cdrfiuba/tco/Informe/codigo_fuente.pdf

Proyecto (66.09) [Junio 2013] | TCO

## 1. Codigo fuente

## main.c

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

Proyecto (66.09) [Junio 2013] | TCO

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

## main.h

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

## motores.c

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

Proyecto (66.09) [Junio 2013] | TCO

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

Proyecto (66.09) [Junio 2013] | TCO
176 | i f ( d i s t a n c i a < 0 x00000650 ) {
177
178 | variar_PWM ( 2 0 0 , 2 0 0 ) ;
179
180 | PORTD | = MOTOR_DER_DIRECTION; | / / Pongo en a l t o e l pi n DIRECTION
| d e l m ot o r 1
181 | PORTB &= ~MOTOR_DER_BRAKE; | / / Pongo en b aj o e l pi n BRAKE d e l
| m ot o r 1
182
183 | PORTD | = MOTOR_IZQ_DIRECTION ; | / / Pongo en a l t o e l pi n DIRECTION
| d e l m ot o r 2
184 | PORTB &= ~MOTOR_IZQ_BRAKE; | / / Pongo en b aj o e l pi n BRAKE d e l
| m ot o r 2
185
186 | w hil e ( f l a g _ f i n _ r o t a c i o n == FALSE ) {
187
188 | i f ( c u e n t a _ e n c o d e r _ d e r e c h a >= 1 5 ) {
189
190 | i f ( c u e n t a _ e n c o d e r _ i z q u i e r d a >= 1 5 ) {
191
192 | f l a g _ f i n _ r o t a c i o n = TRUE;
193
194 | }
195 | }
196 | }
197 | }
198
199 | i f ( d i s t a n c i a > 0 x00000750 ) {
200
201 | variar_PWM ( 2 0 0 , 2 0 0 ) ;
202
203 | PORTD &= ~MOTOR_DER_DIRECTION; | / / Pongo en b aj o e l pi n DIRECTION
| d e l m ot o r 1
204 | PORTB &= ~MOTOR_DER_BRAKE; | / / Pongo en b aj o e l pi n BRAKE d e l
| m ot o r 1
205
206 | PORTD &= ~MOTOR_IZQ_DIRECTION ; | / / Pongo en b aj o e l pi n DIRECTION
| d e l m ot o r 2
207 | PORTB &= ~MOTOR_IZQ_BRAKE; | / / Pongo en b aj o e l pi n BRAKE d e l
| m ot o r 2
208
209 | w hil e ( f l a g _ f i n _ r o t a c i o n == FALSE ) {
210
211 | i f ( c u e n t a _ e n c o d e r _ d e r e c h a >= 1 5 ) {
212
213 | i f ( c u e n t a _ e n c o d e r _ i z q u i e r d a >= 1 5 ) {
214
215 | f l a g _ f i n _ r o t a c i o n = TRUE;
216
217 | }
218 | }
219 | }
220 | }
221 | }

Proyecto (66.09) [Junio 2013] | TCO

## motores.h

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

## encoders.c

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

Proyecto (66.09) [Junio 2013] | TCO
12 | PORTD | &= ~(1 < <PD2 ) ; | / / D e s a c t i v o e l p u l l up
13
14 | GICR | | = (1 < < INT0 ) ; | / / A c t i v o INT0
15 | GICR | | = (1 < < INT1 ) ; | / / A c t i v o INT1
16 | / / GICR &= ~(1<< INT2 ) ; | / / D e s a c t i v o INT2
17
18 | MCUCR | | = ( (1 < < ISC01 ) | (1 < < ISC00 ) ) ; | / / C o nfi g u r o l a INT0 p o r
f l a n c o a s c e n d e n t e
19 | MCUCR | | = ( (1 < < ISC11 ) | (1 < < ISC10 ) ) ; | / / C o nfi g u r o l a INT1 p o r
f l a n c o a s c e n d e n t e 20
21 }

## encoders.h

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

## pwm.c

1
2 # i n cl u d e "pwm. h "
3
4 v oi d i ni ci ali z a r _ PWM ( v oi d ) {
5
6 TCCR1A = ( ( 1 << COM1A1) | ( 1 << COM1A0) | ( 1 << COM1B1) | ( 1 << COM1B0) | ( 0 <<
WGM11) | ( 1 << WGM10) ) ;
7 | / / COM1A1=1 , COM1A0=1 , COM1B1=1 , COM1B0=1 , WGM11=0 , WGM10=1
8 | / / C o n f i g u r a c i o n d e l PWM como f a s t PWM de 8 b i t s
9
10 | TCCR1B = ( ( 0 << WGM13) | ( 1 << WGM12) ) ;
11 | / / Time r Apagado WGM13=0 , WGM12=1 , CS12=0 , CS11=0 , CS10=0
12
13 | / / C o n f i g u r a c i o n de d i r e c c i o n de p u e r t o s I /O
14 | / / DDRA=0x00 ; / / P u e rt o A como e nt r a d a
15 | / / DDRC=0xFF ; / / P u e rt o C como s a l i d a
16 | / / DDRD=0xFF ; / / Pi n 3 y 4 d e l p u e r t o B como s a l i d a
17 | DDRD | = (1 < <4 ) | ( 1 < < 5 ) ;
18 | / / PORTA=0xFF ; / / H a b i l i t a c i o n de p u l l −u p s d e l p u e r t o A

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

## pwm.h

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

## sensoresPared.c

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

Proyecto (66.09) [Junio 2013] | TCO

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

Proyecto (66.09) [Junio 2013] | TCO
68 | r e t u r n c u e n t a s ;
69 | }

## sensoresPared.h

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

## sensoresPiso.c

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

Proyecto (66.09) [Junio 2013] | TCO

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

## sensoresPiso.h

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
