cdrfiuba/tco/Anteproyecto/diagrama_bloques_hard.png

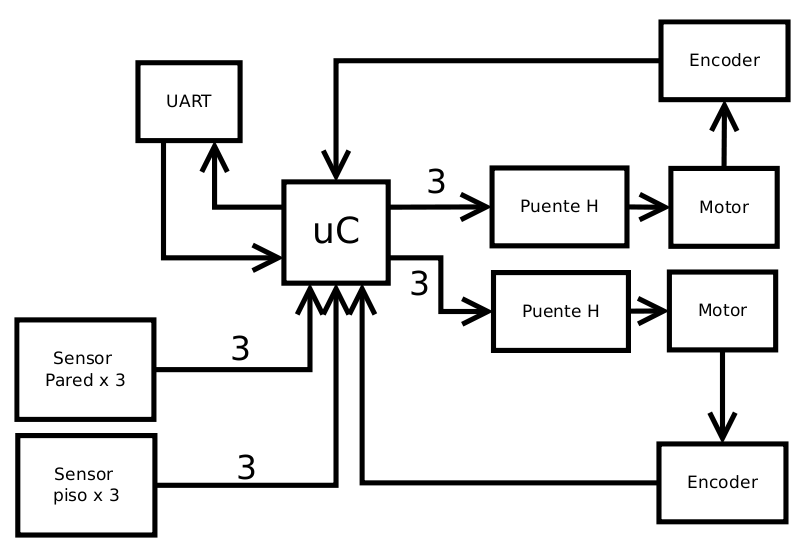
Anteproyecto/diagrama_bloques_hard.png
