cdrfiuba/tco/Anteproyecto/diagrama_flujo.png

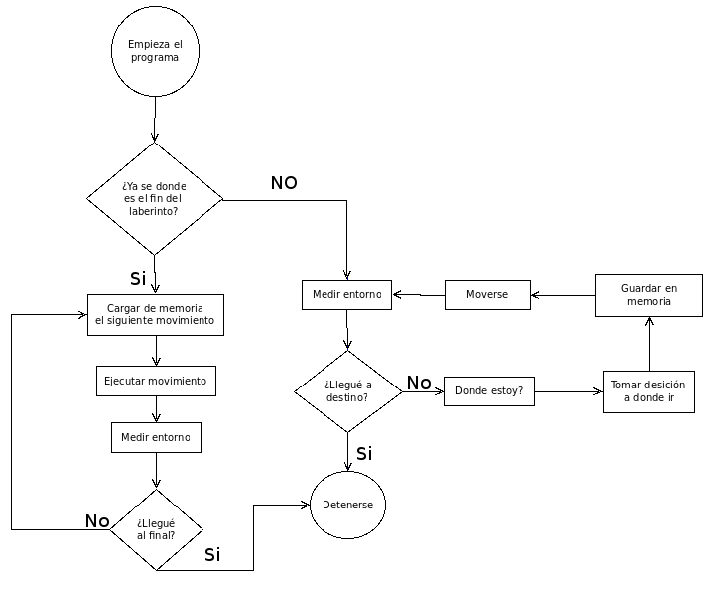
Anteproyecto/diagrama_flujo.png
