cdrfiuba/tco/2013C1TCO/TCO/Esquemáticos/alimentacion.pdf

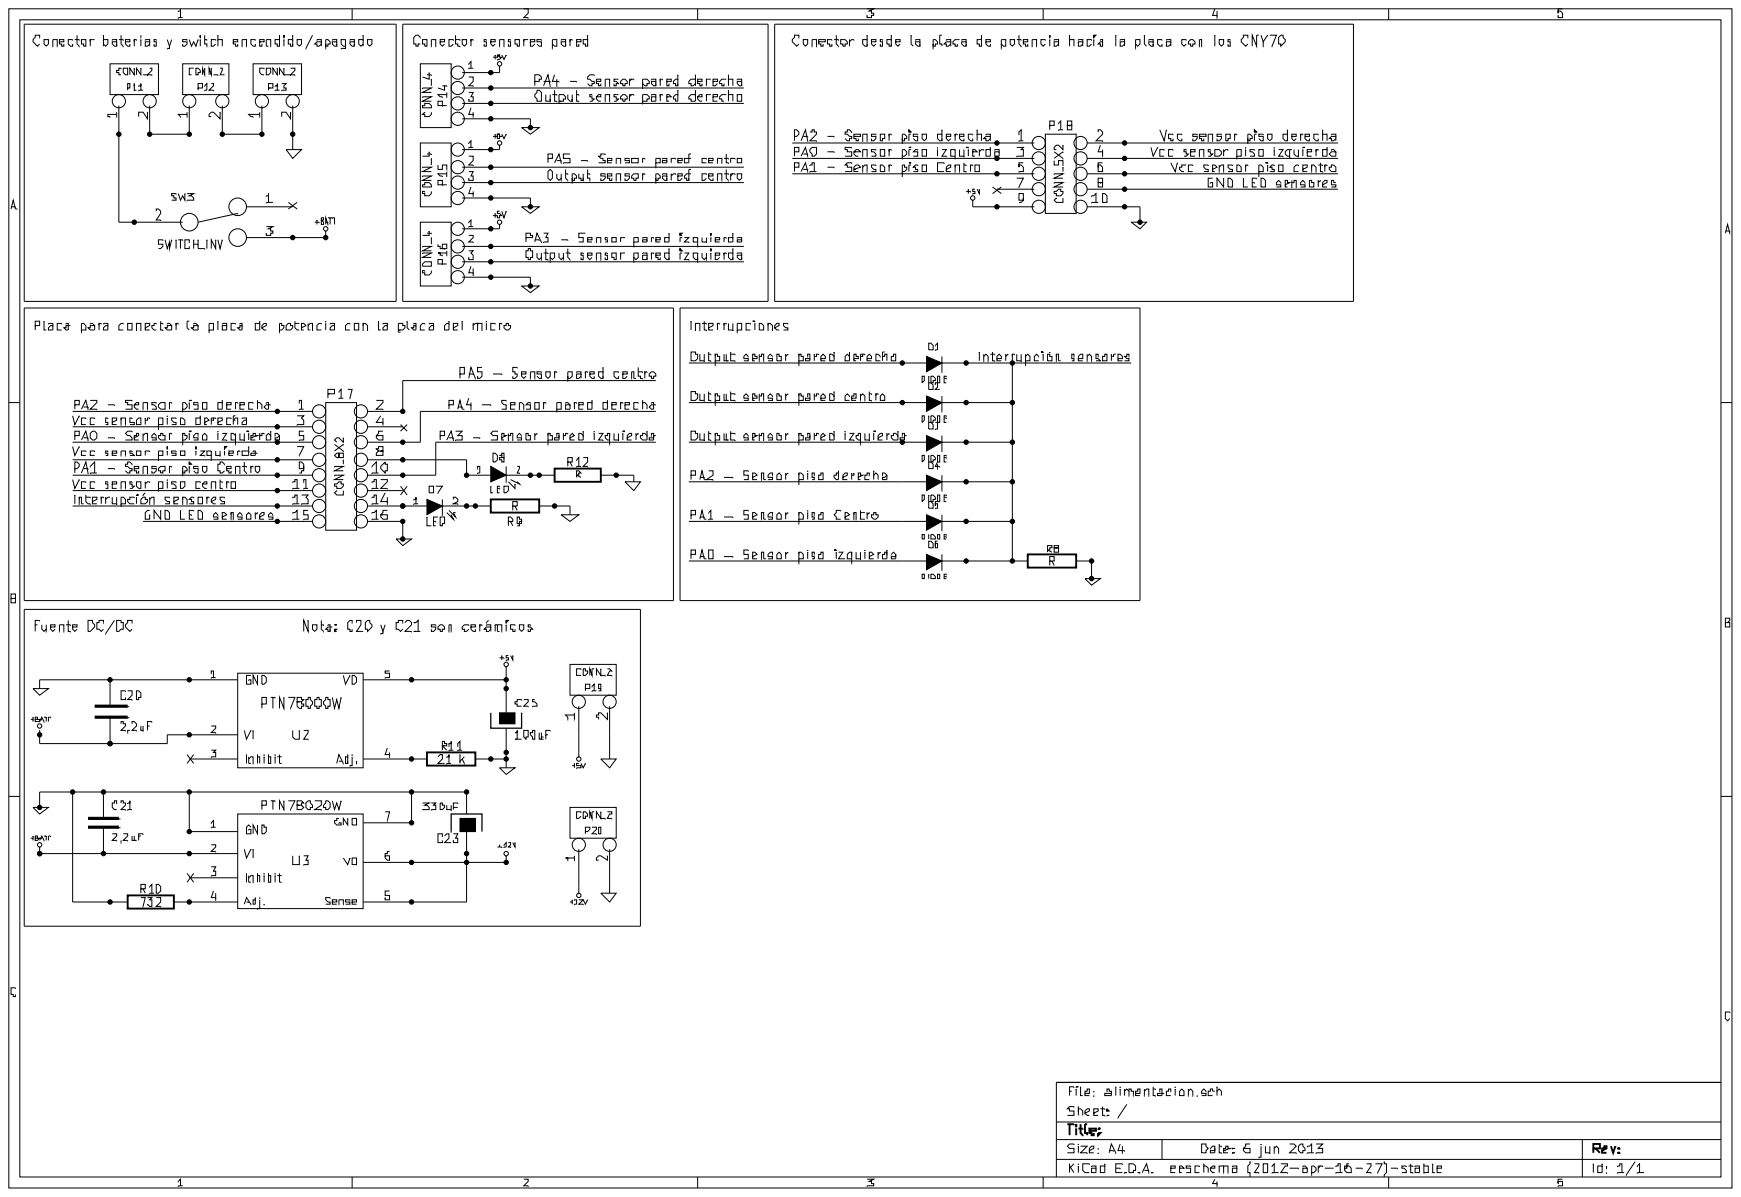
[picture p19: page 1]
