cdrfiuba/tco/2013C1TCO/TCO/Esquemáticos/micro.pdf

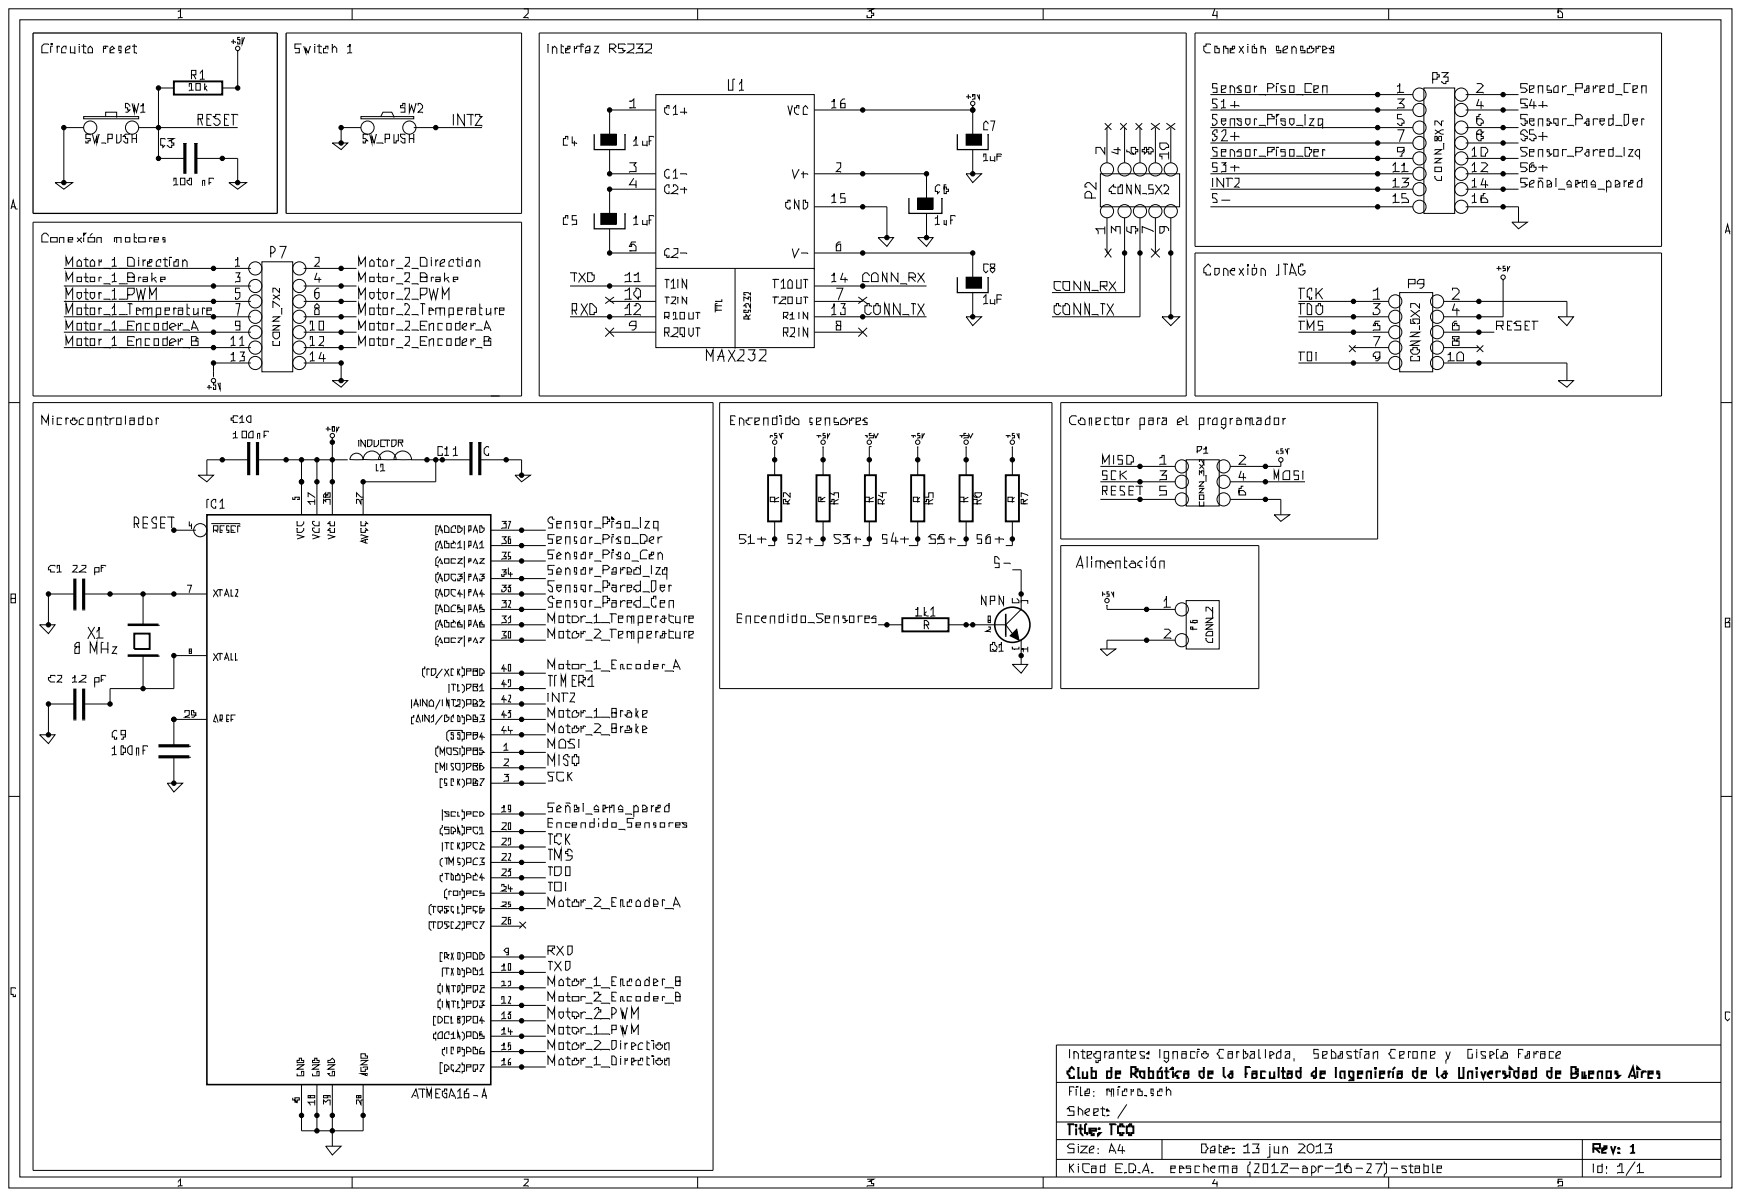
[picture p20: page 1]
