cdrfiuba/tco/2013C1TCO/TCO/Esquemáticos/motores.pdf

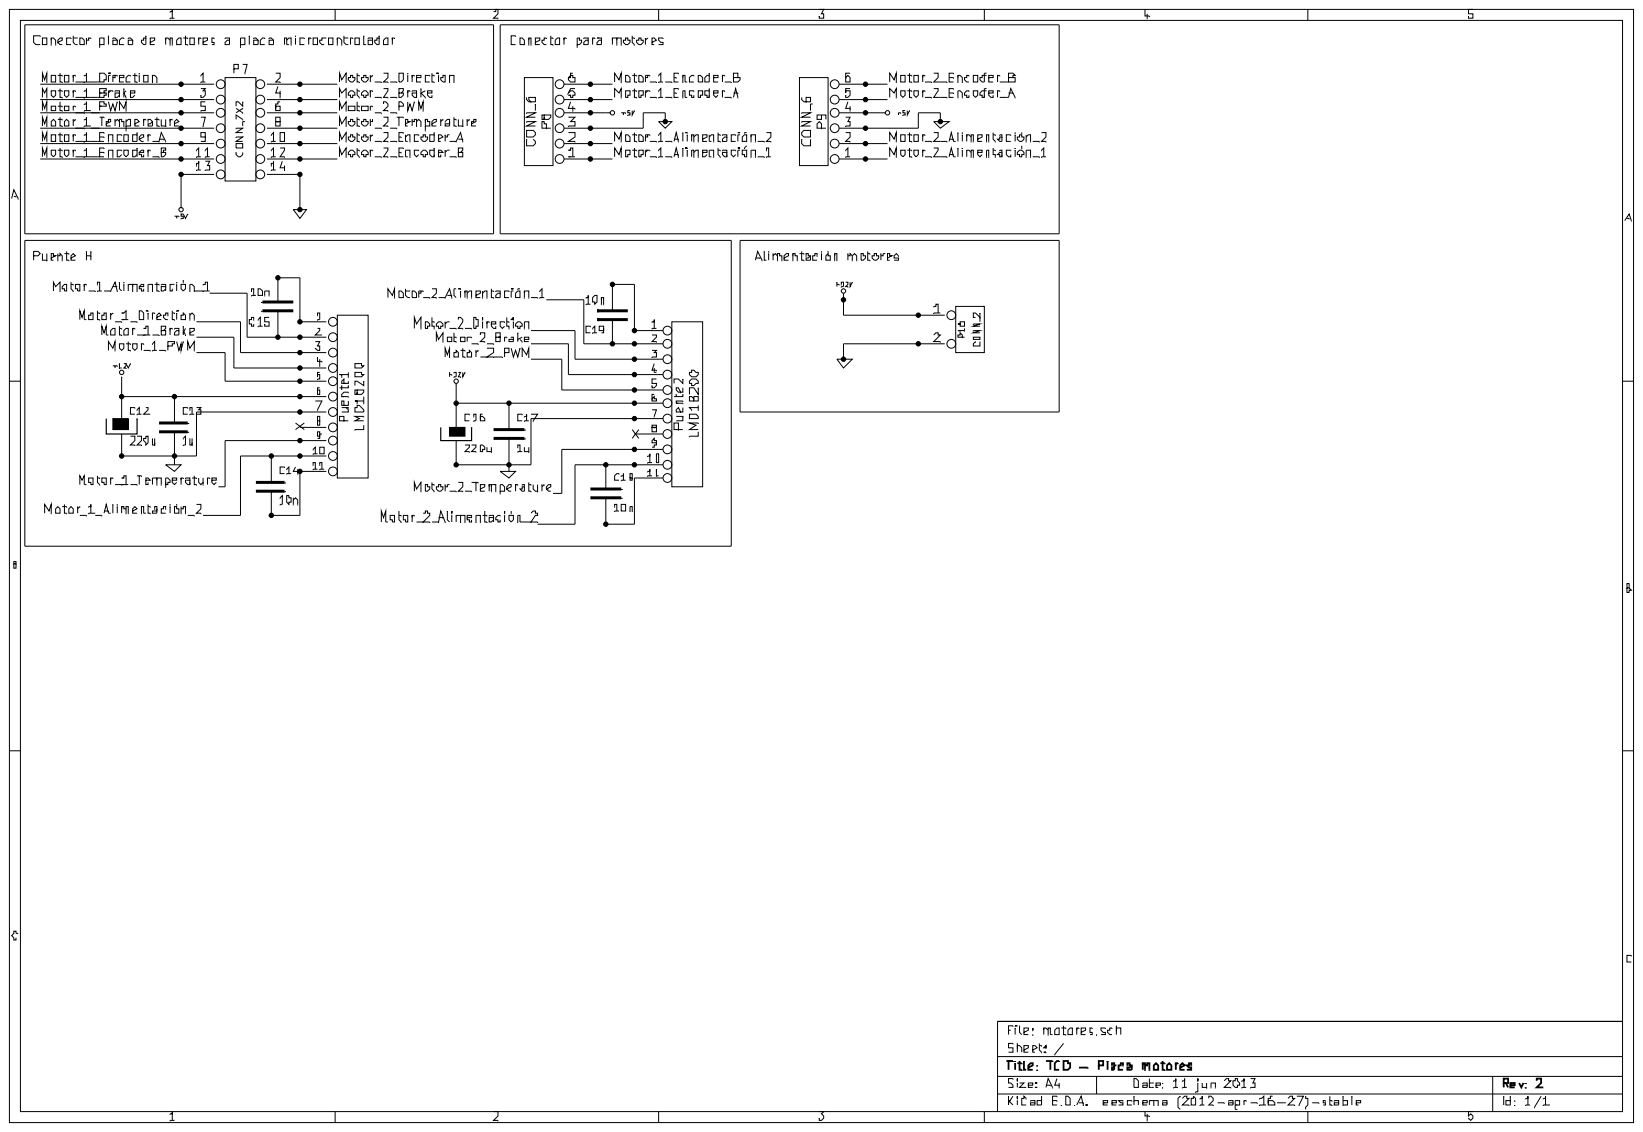
[picture p21: page 1]
