cdrfiuba/tco/2013C1TCO/TCO/Esquemáticos/sensores.pdf

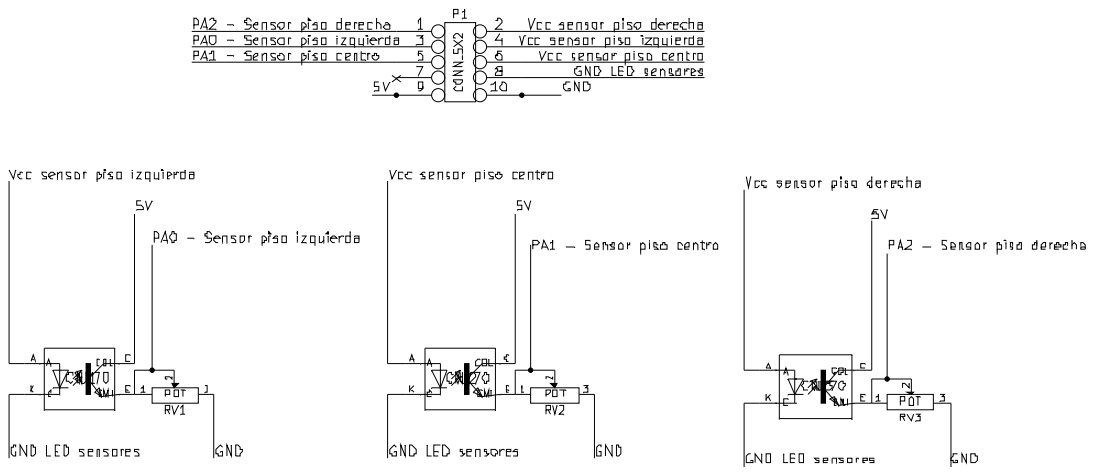
[picture p22: page 1]
