cdrfiuba/tco/Placa/sensores.kicad_pcb

## KiCad design Placa/sensores.kicad_pcb (2013-05-27)

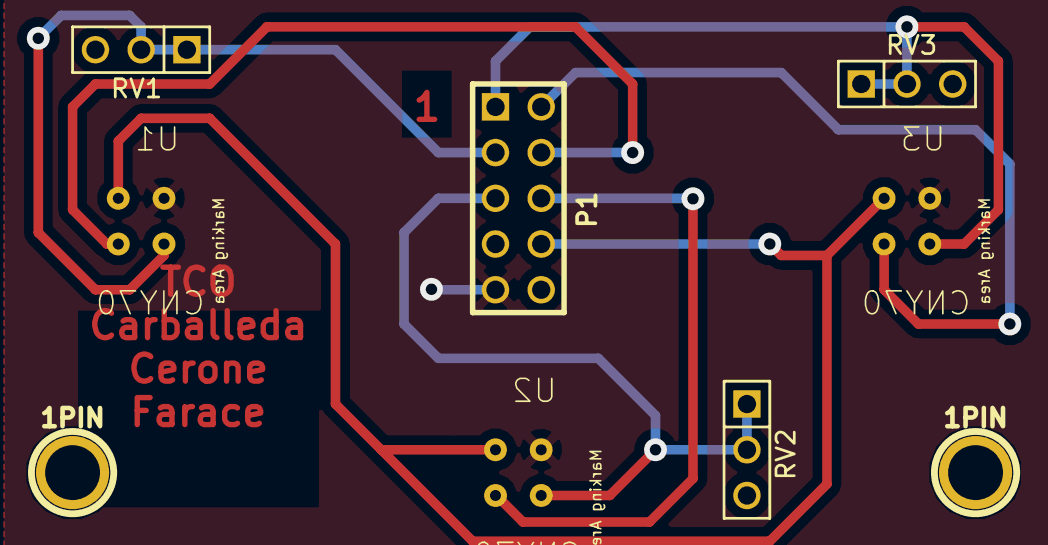
[picture p23: board sensores.kicad_pcb from above]

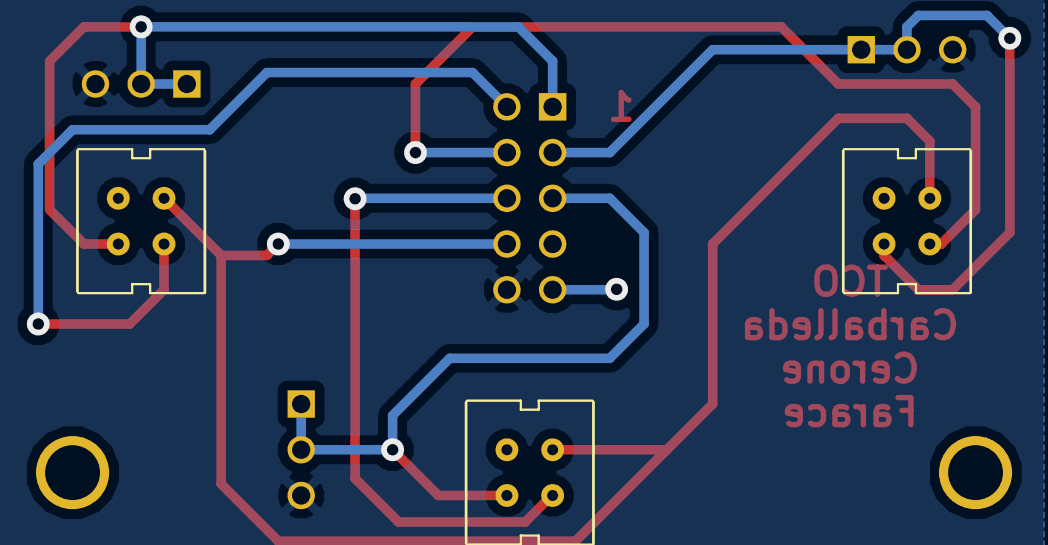
[picture p24: board sensores.kicad_pcb from below]

Board: 2 copper layers, 9 parts (3 on the bottom side), 9 nets.

Parts:
1PIN, 1PIN#2: P***; 1pin
P1: CONN_5X2; PIN_ARRAY_5x2
RV1, RV2, RV3: POT; PIN_ARRAY_3X1
U1, U2, U3: CNY70; cny70-4

Connections:
/5V: P1.9, U1.C, U2.C, U3.C
/GND: P1.10, RV1.3, RV2.3, RV3.3
/GND LED sensores: P1.8, U1.K, U2.K, U3.K
/PA0 - Sensor piso izquierda: P1.3, RV1.1, RV1.2, U1.E
/PA1 - Sensor piso centro: P1.5, RV2.1, RV2.2, U2.E
/PA2 - Sensor piso derecha: P1.1, RV3.1, RV3.2, U3.E
/Vcc sensor piso centro: P1.6, U2.A
/Vcc sensor piso derecha: P1.2, U3.A
/Vcc sensor piso izquierda: P1.4, U1.A
