cdrfiuba/tco/Placa/alimentacion.sch

## KiCad design Placa/alimentacion.sch (2013-06-06)

Schematic: alimentacion.sch

Parts:
C20, C21: 2,2uF
C23: 330uF
C25: 100uF
D1, D2, D3, D4, D5, D6: DIODE
D7, D8: LED
P11, P12, P13, P19, P20: CONN_2
P14, P15, P16: CONN_4
P17: CONN_8X2
P18: CONN_5X2
R8, R9, R12: R
R10: 732
R11: 21 k
SW3: SWITCH_INV
U2: PTN78000W
U3: PTN78020W

Notes on the sheet:
Placa para conectar la placa de potencia con la placa del micro
Conector desde la placa de potencia hacia la placa con los CNY70
Nota: C20 y C21 son cerámicos
Interrupciones
Fuente DC/DC
Conector sensores pared
Conector baterías y switch encendido/apagado
