cdrfiuba/tco/Placa/micro.sch

## KiCad design Placa/micro.sch (2013-06-06)

Schematic: micro.sch

Parts:
1k1: R
C1, C2: 12 pF
C3, C5, C6: 100nF
C4: 100 nF
C7, C8, C9, C10, C11: 1uF
IC1: ATMEGA16-A; TQFP44
L1: 10uH
P1: CONN_7X2
P2, P5: CONN_5X2
P3: CONN_3X2
P4: CONN_2
P6: CONN_8X2
Q1: NPN
R1: 10k
R2, R3, R4, R5, R6, R7: R
SW1, SW2: SW_PUSH
U1: MAX232
X1: 8 MHz

Notes on the sheet:
Conexión sensores
Conexión JTAG
Alimentación
Encendido sensores
Switch 1
Conexión motores
Microcontrolador
Interfaz RS232
Conector para el programador
Circuito reset
