cdrfiuba/tco/Placa/motores.sch

## KiCad design Placa/motores.sch (2013-06-11)

Schematic: motores.sch

Parts:
C12, C16: 220u
C13, C17: 1u
C14, C15, C18, C19: 10n
P7: CONN_7X2
P8, P9: CONN_6
P10: CONN_2
Puente1, Puente2: LMD18200

Notes on the sheet:
Alimentación motores
Puente H
Conector para motores
Conector placa de motores a placa microcontrolador
