cdrfiuba/tco/Placa/sensores.sch

## KiCad design Placa/sensores.sch (2013-05-27)

Schematic: sensores.sch

Parts:
P1: CONN_5X2
RV1, RV2, RV3: POT
U1, U2, U3: CNY70
