cdrfiuba/tco/(commit log)

2013-04-14 Subo archivos: Esquematico de sensores de piso (Kicad) y Primera aproximacion a su ubicacion (Dia)
    [sensores.sch]
2013-04-26 añado digramas de flujo.
2013-04-26 agrego los archivos de diseño modificados a carpeta "dia" , dentro de informe
2013-04-28 Agrego archivos nuevos. Placa microcontrolador terminada Proyecto kicad todas las placas Algunos datasheet Algunas imagenes Documentos anteproyecto
    [TCO.sch, alimentacion.sch, micro.brd, micro.sch, motores.sch, sensores.sch]
2013-04-28 agrego exports para crear PCB
    [micro-Back.gbl, micro-Front.gtl, micro-PCB_Edges.gbr, micro.drl]
2013-04-29 Agrego cambios en la placa microcontrolador, propuestos por Joaco:
    1) Agrego filtro para los AD
    2) Agrego resistencias para cada led de los sensores
    3) Hice algo mas pero no recuerdo que.
    [micro.brd, micro.sch]
2013-04-29 Ahora si, hice un update de la última version del repo y subo los cambios.
    [micro.brd, micro.sch]
2013-04-29 Agrego carpeta gerber con los archivos necesarios para gabricar PCB
    [micro-Back.gbl, micro-Front.gtl, micro-PCB_Edges.gbr, micro.drl]
2013-04-30 Termino PCB motores. Agrego biblioteca LMD18200. Agrego el anteproyecto hecho por Gisela.
    [motores.sch]
2013-04-30 Ahora si, agrego los archivos, me había olvidado del Add.
    [motores.brd]
2013-05-02 renuevo gerbers
    [micro-Back.gbl, micro-Front.gtl, micro-PCB_Edges.gbr, micro.drl]
2013-05-02 agrego los ps necesarios para PCB
2013-05-19 agrego gerbers de motores
    [motores-B_Cu.gbl, motores-Edge_Cuts.gbr, motores.drl]
2013-05-22 trabajo en sensores
    [sensores.sch]
2013-05-25 Agrego archivos placa potencia. Agrego biblioteca ptn78020w.
    [TCO.sch, alimentacion.sch, doxygen.cfg, micro.sch, motores.sch, sensores.sch]
2013-05-25 trabajo en Sensores de piso
    [sensores.sch]
2013-05-25 cambio en sensores.pro
    [sensores.sch]
2013-05-26 Agrego alimentación.brd, placa donde se va a montar motores/sensores/baterías.
    [TCO.sch, alimentacion.brd, alimentacion.sch, micro.sch, motores.sch, sensores.sch]
2013-05-26 arreglo placa sensores
    [sensores.sch]
2013-05-27 Termino y ruteo placa Sensores, Creo Gerbers de Placa de sensores y de Alimentacion.
    [sensores.kicad_pcb, sensores.sch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]
2013-05-27 agrego Gerbers de Sensores
    [sensores.kicad_pcb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]
2013-05-27 Agrego codigo que usa interrupciones atmega88
2013-05-27 reemplazo un gerber que estaba fuera de cuadro.
2013-05-29 hago pwm
2013-05-30 agrego carpeta con Makefile y pwm.c
2013-05-31 Agrego Make funcionando para atmega16. Agrego serie.c función que utiliza la interrupción de puerto serie para hacer un ECHO. Probado y funcionando. Agrego hgignore y lo modifico para no versionar ar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
2013-06-01 Agrego PWM funcionando. Falta hacer el codigo más prolijo.
2013-06-02 Agrego archivo "encoders.c" : se inicializan y configuran los timers 0 y 2. Modifico "pwm.c": emprolijo codigo
2013-06-02 Agrego archivos placa motor Rev:2.0 Agrego un intento de ir juntando todo en un solo lugar. Todavía falta.
    [doxygen.cfg, motores.brd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]
2013-06-02 Agrego funciones manejo de motores.
2013-06-02 modifico pwm.c
2013-06-02 Completo funciones manejo de motores. Todavía falta hacer algunos retoques.
2013-06-02 Agrego función para enviar una cadena de caracteres por el puerto serie. Modifico interrupción del puerto serie para cargar los datos recibidos en un string. Si se reciben más datos que la longitud d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
2013-06-02 Funcion para sensores de pared
2013-06-03 agrego funcion avanzar_celda() en motores.c
2013-06-03 agrego algoritmo para los sensores del piso.
    [motores-Edge_Cuts.gbr]
2013-06-03 arreglo algo en motores.c (cambio una comparacion en funcion avanzar_celda )
    [motores.c]
2013-06-03 Cambio nombre de algunas carpetas, tenian espacios y era molesto para trabajar con la consola. Modifico funciones manejo sensores de distancia. Todavía no esta terminada, lo agrego a modo de referenc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
2013-06-03 Me olvidé de agregar los archivos.
2013-06-03 agrego carpeta donde hago codigo para velocista, cambio funcion avanzar_celda
2013-06-05 Agrego prueba rapida para medición sensor distancia pared.
2013-06-06 Prueba sensor distancia. Tenemos un problema que se queda colgado el sensor y hay que volver a hacer un trigger para sacarlo de ese estado.
    [main.c, sensores_pared.c]
2013-06-06 Algunos arreglos, no se si va andar.
    [sensores_pared.c]
2013-06-06 Subo lo último que tengo. Midiendo distancia pared. Cuando mide distancias grandes (mayor a 30 cm) se cuelga.
2013-06-06 Ahora si, borre los archivos que estaban molestando.
2013-06-06 agrego carpeta con pruebas para encoder
2013-06-06 Agrego cambios funciones en prueba para agregar los encoders. No funciona.
2013-06-06 Agrego modificiaciones al codigo tco/Source/programa
    Mide distancia en forma estable.
    Corregí el tipo de las variables.
2013-06-06 Hice la documentacion para la compentencia. Ademas arregle en el Kicad el reset del micro.
    [TCO.sch, alimentacion.sch, micro.sch, motores.sch, sensores.sch]
2013-06-06 Funcionan los 3 sensores de pared.
2013-06-07 Primera prueba de TCO en movimiento. Trando de mantener una distancia fija.
2013-06-08 Intento de codigo medio cabeza
2013-06-08 Conjunto de cambios retirado: f4b842901451
2013-06-08 Recorre el laberinto maso menos muy cabeza
2013-06-08 Intento de resolverdor, resulve el laberinto girando a la derecha. Falta resolver error al moverse.
    [main.c, sensores_pared.c, sensores_pared.h]
2013-06-08 Creemos que funciona. Hay que empezar a hacer pruebas y poner la corrección de rumbo.
2013-06-08 cambiamos cables , sensores por separado
2013-06-10 Somos felices! Los sensores de distancia no se cuelgan.
2013-06-11 Intentado hacer funcinar los encoders, posible error de configuracion, el Timer2 cuenta cuando no deberia.
    [encoders.c, encoders.h, main.c, main.h, motores.c, motores.h, pwm.c, sensores_pared.c]
2013-06-11 Agrego algunas imagenes para el wiki.
2013-06-11 Hago un merge a mano entre la versión que recorrió el laberinto en la competencia Megaman y la que tiene solucionado el problema de los sensores. Hice un make y compila, de todas formas hay que proba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
    Borré archivos que creo no se estan usando. De todas formas, esta todo versionado.
    [encoders.c, encoders.h, main.c, main.h, motores.c, motores.h, pwm.c, pwm.h]
2013-06-11 Placa microcontrolador revisión 2. Agrego modificaciones: posibildad de encender todos los sensores desde el micro. Identificar interrupción de cada sensor.
    [TCO.sch, alimentacion.sch, micro.sch, motores.sch, sensores.sch]
2013-06-11 Me olvidé de agregar los LED's indicadores.
    [TCO.sch, alimentacion.sch, micro.sch, motores.sch, sensores.sch]
2013-06-11 Agrego retoques en 2da revisión PCB micro
    [TCO.sch, alimentacion.sch, micro.sch, motores.sch, sensores.sch]
2013-06-12 Se agrega PCB placa micros revisión 2.
    [micro.brd, micro.sch]
2013-06-12 Se agrandan los agujeros de la placa para que los componentes entren mejor.
    [micro.brd]
2013-06-12 Modificación placas 2da revisión.
    Placa microcontrolador: Se terminó el PCB. Se agrandaron los agujeros. Se agregó texto. Ya esta lista para fabricar.
    Placa motores: Se agregó texto para tener referencia y evitar que salga al revés.
    Placa alimentación: Se tomaron las mediciones para poner las placas anterior correctamente. Falta terminar el PCB.
    [alimentacion.brd, micro.brd, motores.brd]
2013-06-12 Funcion para los sensores de piso
2013-06-12 Funciona bien, con la modificacion de la medición de pared. Con esto hubieramos ganado la competencia.
2013-06-13 Se esta midiendo distancia utilizando el mismo timer que el PWM. De esta forma nos ahorramos un timer para poder utilizar los encoders.
2013-06-13 Pruebas con los encoders. Todavía no funciona,
2013-06-13 Agrego esquematico versión 1 PCB micro para poder usar de referencia hasta que fabriquemos la segunda placa.
    [micro.sch]
2013-06-13 Codigo con sensores de piso funcionando.
2013-06-15 Encoder rueda derecha funciona OK. Vamos por la izquierda!
2013-06-15 Agrego configuración timer 2 para poder contar encoder. Pero no funciona.
2013-06-15 Se hacen avances en la utilizacion del encoder. Rueda derecha funciona ok. Se utiliza la interrupción por overflow para sumar más distancia.
    Rueda izquierda configurada, pero no anda como corresponde.
2013-06-15 Prueba para ver los valores de los dos encoders a través del puerto serie. No funciona el encoder de la rueda izquierda
2013-06-18 Se hacen pruebas para usar el encoder de la rueda izquierda sin el timer, solo mirando el estado del puerto. No funciona.
2013-06-18 Funciona el encoder de la rueda izquierda viendo todo el tiempo el estado del puerto. De todas formas da muy distinto que la rueda derecha con el timer (482 pulsos contra 272). Hay que probar con la 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
2013-06-18 Funcionan los dos encoders! La rueda derecha por un contador en T0 y la rueda izquierda por interrupción.
2013-06-18 Mejorando la función que rota a la derecha e izquierda. Seguramente haya que cambiar la cantidad de pulsos que rota.
2013-06-18 Algunos avances, pero con problemas de medición de distancia de nuevo.
    [main.c, main.h, motores.c]
2013-06-19 Agrego avanzar con cantidad de pulsos.
2013-06-20 Avances en la corrección de sentido. Funciona bien. Falta ajustar.
2013-06-20 Ultima prueba del día. Funciona muy bien, pero falta corregir el rumbo despues del giro. Mantiene el recorrido en linea recta bastante bien, aunque falta comprar contra la pared.
2013-06-20 Se agrega una funciona que intenta corregir el rumbo. Ayuda un poco, pero hay que mejorarla.
2013-06-20 Agrego medición del piso, pero no funciona. Seguramente olvidé alguna configuración.
    [TCO.sch, alimentacion.brd, alimentacion.sch, micro.brd, micro.sch, motores.brd, motores.sch, sensores.sch]
2013-06-20 Estaba funcionando muy bien, pero ahora mide siempre FFFF en el sensor de la derecha.
2013-06-21 Versión estable: Sale del laberinto. Falta agregar corrección de rumbo.
2013-06-22 Realizó tres ciclos seguidos antes de pegarse contra la pared. La función de corrección de rumno parece qeu corrige. De todas formas todavía falta ajustar un par de cosas.
    [main.c, main.h, motores.c]
2013-06-22 Modificaciones sobre la corrección de rumbo.
2013-06-22 Se agrega carpeta para preparar CD siguiendo indicaciones página web de la materia. Se empieza informe en latex siguiendo plantilla ya armada para otro TP.
2013-06-22 Avances en el informe. Ya esta la caratula y el cuerpo. Falta agregar información.
2013-06-23 Se resolvió problema al medir el piso, otra función desactivaba la interrupción.
    [encoders.c, main.c, motores.c, sensores_pared.c, sensores_piso.c]
2013-06-24 Se detiene cuando llega a la salida. Pero no corrige bien, y hace algo raro al girar a la izquierda.
    [main.c, sensores_piso.c, sensores_piso.h]
2013-06-24 Se agregan avances en el informe.
2013-06-24 Versión final para entregar el miercoles. Se corrigieron detalles de funcionamiento. Se acomodó el código. Se probó y funciona bien.
    [encoders.c, encoders.h, main.c, motores.c, motores.h, pwm.c, pwm.h, sensores_pared.c]
2013-06-24 Cambio nombre informe_final. Modifico hgignore para no tomar archivos .evs
2013-06-25 edito \subsection{Identificación de color del piso} , (arreglar posibles errores de compilacion)
2013-06-25 Describo como utilizamos nuestros sensores de pared, Arreglo problema por el cual no compilaba.
2013-06-25 Se hacen algunas correcciones en el Informe.
2013-06-25 Avances del informe. Se agrega lista de materiales.
2013-06-26 Agrego diagrama de flujo del algoritmo principal que sale del laberinto. Comento linas de imagenes que agregan imagenes que no estan en /img.
2013-06-26 Se hacen cambios en el informe. Se agrega información. Se corrige ortografia. Se agregan los esquemáticos en la carpeta del proyecto.
2013-06-26 Se agrega comunicación, y encoders. Tambien un poco de conclusiones.
2013-06-26 agrego explicacion PWM y Motores
2013-06-26 Agrego info a explicación sobre encoders, agrego items a software utilizado.
2013-06-26 agrego info a encoders y software utulizado
2013-06-26 Agrego versiones finales. CD listo para quemar.
2013-07-05 Se hacen correcciones en el informe. Se borran archivos innecesarios.
2013-07-05 Se hacen más correcciones en el informe.
2013-07-06 Se cargaron las versiones correctas de los esquemáticos y los PCB.
    [TCO.sch, alimentacion.brd, alimentacion.sch, micro.brd, micro.sch, sensores.kicad_pcb, sensores.sch]
2013-07-06 Se agrega PCB para base motores.
    [base_motores.brd]
